nikola01pz/christmas-tree/christmas_tree.kicad_sch

## KiCad design christmas_tree.kicad_sch (2023-11-18)

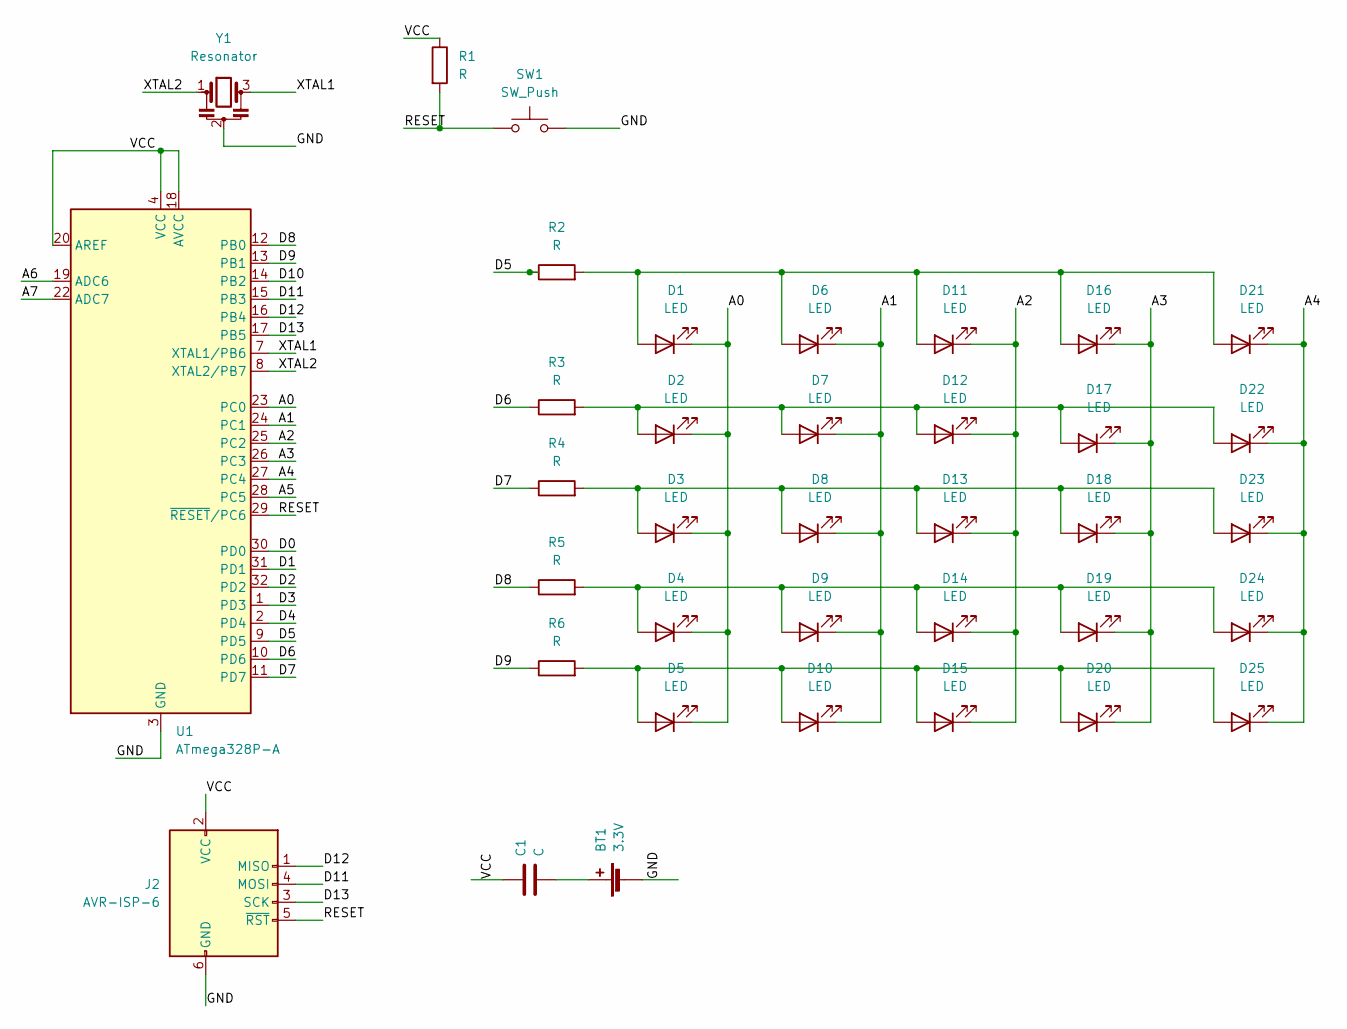
[picture p10: schematic christmas_tree.kicad_sch]

Parts:
BT1: 3.3V; BatteryHolder_Keystone_107_1x23mm
C1: C; C_0805_2012Metric
D1, D2, D3, D4, D5, D6, D7, D8, D9, D10, D11, D12, D13, D14, D15, D16, D17, D18, D19, D20, D21, D22, D23, D24, D25: LED; LED_0805_2012Metric
J2: AVR-ISP-6; IDC-Header_2x03_P2.54mm_Vertical
R1, R2, R3, R4, R5, R6: R; R_0805_2012Metric
SW1: SW_Push; SW_SPST_CK_RS282G05A3
U1: ATmega328P-A; TQFP-32_7x7mm_P0.8mm
Y1: Resonator; Resonator_SMD_Murata_CSTxExxV-3Pin_3.0x1.1mm

Connections:
A0: D1.1 (K), D2.1 (K), D3.1 (K), D4.1 (K), D5.1 (K), U1.23 (PC0)
A1: D6.1 (K), D7.1 (K), D8.1 (K), D9.1 (K), D10.1 (K), U1.24 (PC1)
A2: D11.1 (K), D12.1 (K), D13.1 (K), D14.1 (K), D15.1 (K), U1.25 (PC2)
A3: D16.1 (K), D17.1 (K), D18.1 (K), D19.1 (K), D20.1 (K), U1.26 (PC3)
A4: D21.1 (K), D22.1 (K), D23.1 (K), D24.1 (K), D25.1 (K), U1.27 (PC4)
A5: U1.28 (PC5)
A6: U1.19 (ADC6)
A7: U1.22 (ADC7)
D0: U1.30 (PD0)
D1: U1.31 (PD1)
D2: U1.32 (PD2)
D3: U1.1 (PD3)
D4: U1.2 (PD4)
D5: R2.1, U1.9 (PD5)
D6: R3.1, U1.10 (PD6)
D7: R4.1, U1.11 (PD7)
D8: R5.1, U1.12 (PB0)
D9: R6.1, U1.13 (PB1)
D10: U1.14 (PB2)
D11: J2.4 (MOSI), U1.15 (PB3)
D12: J2.1 (MISO), U1.16 (PB4)
D13: J2.3 (SCK), U1.17 (PB5)
GND: BT1.2 (-), J2.6 (GND), SW1.2, U1.3 (GND), U1.5 (GND), U1.21 (GND), Y1.2
unnamed: BT1.1 (+), C1.2
unnamed: D1.2 (A), D6.2 (A), D11.2 (A), D16.2 (A), D21.2 (A), R2.2
unnamed: D5.2 (A), D10.2 (A), D15.2 (A), D20.2 (A), D25.2 (A), R6.2
unnamed: D2.2 (A), D7.2 (A), D12.2 (A), D17.2 (A), D22.2 (A), R3.2
unnamed: D3.2 (A), D8.2 (A), D13.2 (A), D18.2 (A), D23.2 (A), R4.2
unnamed: D4.2 (A), D9.2 (A), D14.2 (A), D19.2 (A), D24.2 (A), R5.2
RESET: J2.5 (~RST), R1.2, SW1.1, U1.29 (~RESET/PC6)
VCC: C1.1, J2.2 (VCC), R1.1, U1.4 (VCC), U1.6 (VCC), U1.18 (AVCC), U1.20 (AREF)
XTAL1: U1.7 (XTAL1/PB6), Y1.3
XTAL2: U1.8 (XTAL2/PB7), Y1.1
